Tashar02/rogue_wifi_ap_detector/(commit log)

2026-08-08 rogue-wifi-ap-detector: Implement WiFi repeater and leverage LEDs properly
    Implement WiFi repeater where ESP32 will supply internet access to other devices
    using its own WiFi but it's actually collecting mobile data via the hotspot
    connection which it connected to before. We leverage ESP32's AP and STA both at
    once for this. We also refactor LED usage and use ESP32 C6's own RGB LED as well
    for proper LED signaling now.
2026-08-08 rogue-wifi-ap-detector: Fix false-positive double clicks
    [rogue-wifi-ap-detector.ino]
2026-08-08 rogue-wifi-ap-detector: Shorten feature tag for display print
    [rogue-wifi-ap-detector.ino]
2026-08-16 Add circuit diagram and block diagram
    Cirkit Designer link for circuit diagram: https://app.cirkitdesigner.com/project/f46f5a4c-3476-4ae0-90a8-e6a96caa46cb
    Drawio link for block diagram: https://drive.google.com/file/d/1uZuj1mr8x-OjGVnKRGFQoGhS35gbVhMx/view?usp=sharing
2026-08-17 report: Cite components for the project and add alternative LED selection to challenges
2026-08-17 report: Cite 1 kohm resistor and add to table
2026-08-18 report: Add practical circuit diagram and working prototype images
